Zaaphod/Smoothie_External_Drive_Interface/EPM240 EPM570 Core Board Schematic.png

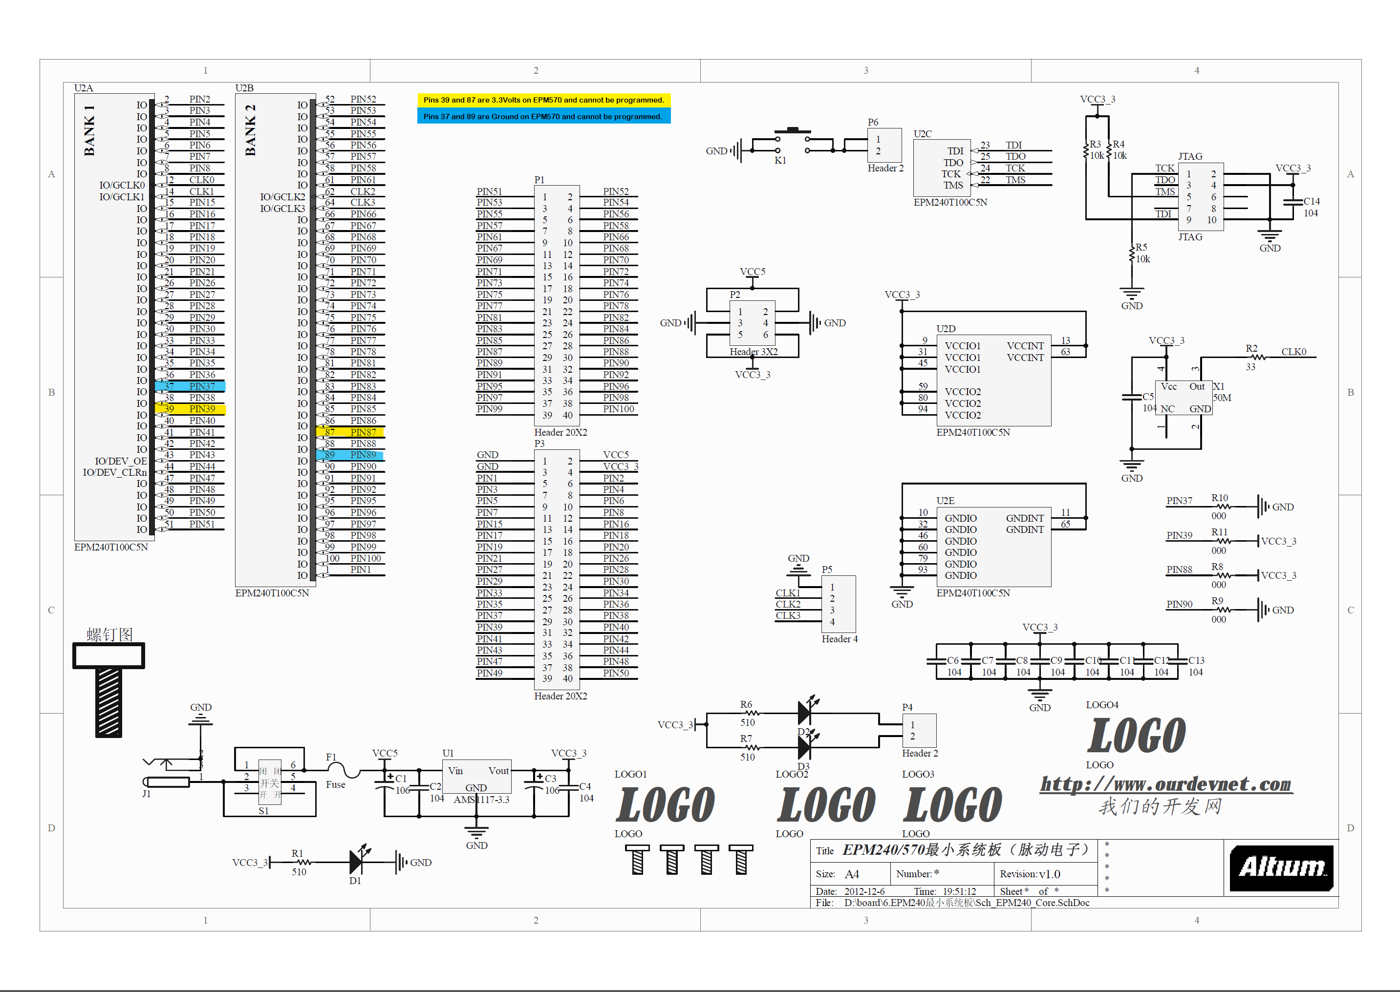
EPM240 EPM570 Core Board Schematic.png
