Zaaphod/Smoothie_External_Drive_Interface/(threads)

Thread 1 (2016-08-01):

Initial Benchtest

Zaaphod, 2016-08-01:
Here are the results of my initial bench test of this project.

I soldered the step and direction pins on a smoothieboard and hooked it up to my CPLD board with some jumpers.  Then I hooked up my logic analyzer to Xenable, Xstep, and Xdirection on smoothieboard, then hooked up Xstep, Xdelayed direction, Ystep and Ydelayed direction on the CPLD board.  I also hooked up my oscillator signal as a reference.
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

Here are some output waveforms:

First is the direction delay.
Grey waveform is the clock signal for the shift registers running at 5MHz
Red waveform is the step input from smoothie, showing the last step pulse before a direction change
Orange waveform is the original direction change that starts ~4µS after the rising edge of the last step  Yellow waveform is the X Step+ output from the CPLD, it is so close to the red input I can't measure it
Green waveform is the delayed direction change.    This confirms the direction signal has been delayed ~12µS and it is now past my 8µS step signal.  The signal shifts though 64 shift registers, the delay can be short by up to 200nS depending on what part of the cycle the clock was in when the delay signal transitioned.
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

Here is the actual measurement of the delay.  12.64µS
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

Here is the Y Delay output in purple, It happens well after the step signal is completed
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

To evaluate the performance of the CPLD, Here are closeups of the rising and falling edges of the step input from smoothie compared to the step output of the CPLD.  measurement of any difference is beyond the capability of my logic analyzer, even running at 100MHz.  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

Next I had a look at the X Axis differential step and direction outputs
Red is the Step input from Smoothieboard
Yellow is the Step + Output from the CPLD
Green is the Step - Output from the CPLD
Orange is the Direction input from Smoothieboard
Blue is the Direction + Output from the CPLD
Purple is the Direction - Output from the CPLD
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

Here is a closeup of some step pulses showing the differential output
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

Here is a closeup of a direction change showing the delay and differential output
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

so far the results are perfect. next step is to get it wired to a machine.

Thread 2 (2016-08-01):

EPM570 Schematic & Board

Zaaphod, 2016-08-01:
Here is the schematic of the CPLD
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

Here's the circuitboard I'm testing with.
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

Here are the CPLD pin assignments:
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

[Pin Wiring.txt](https://github.com/Zaaphod/Smoothie_External_Drive_Interface/files/394319/Pin.Wiring.txt)

Wiring for EPM570T100C5 Board#1
*Note Pins 37 and 89 are  Ground  on EPM570 and cannot be programmed
*Note Pins 39 and 87 are 3.3Volts on EPM570 and cannot be programmed

                                             13   12   11   10    9    8    7    6    5    4    3    2    1    <--DB Ribbon capble pins
         SX+  SX-  SY+  SY-  SZ+  SZ-  LED2  WR       XS-  XD-            XD+  XS+   WP   WD-  WD+ WS+  W-L
          99   97   95   91   89   87   85   83   81   77   75   73   71   69   67   61   57   55   53   51
         100   98   96   92  X90X X88X  86   84   82   78   76   74   72   70   68   66   58   56   54   52
         ZWP  ZSL  WSL  ZWR            LED3 ---  GND  GND  GND  GND  GND  GND  GND  GND  X+L  X-L  WS-  W+L
                             GND  3V3             25   24   23   22   21   20   19   18   17   16   15   14    <--DB Ribbon capble pins

                                             13   12   11   10    9    8    7    6    5    4    3    2    1    <--DB Ribbon capble pins
                    SEN  SXS  SYS  SZS IOSC       ZR   ZS-  ZD-  ZP  ZWP  ZD+  ZS+        YD-  YD+ YS+  Y-L
          5V  3V3    2    4    6    8   16   18   20   26   28   30   34   36   38   40   42   44   48   50
         GND  GND    1    3    5    7   15   17   19   21   27   29   33   35  X37X X39X  41   43   47   49
               SG   OSC  SXD  SYD  SZD XOSC XO/10 GND GND  GND  GND  GND  GND  GND  3V3  Z+L  Z-L  YS-  Y+L
                                                  25   24   23   22   21   20   19   18   17   16   15   14    <--DB Ribbon capble pins
Pin Definitions:
5V  -   5V Power
3V3 - 3.3V Power
GND - Ground Connection
LED1- On Board LED1 - Power Indicator01
LED2- On Board LED2 - Set to OSC/4000000 - blink led to show CPLD is working
LED3- On Board LED3 - Set to OSC/2000000 - blink led to show CPLD is working
XOSC- External Crystal Oscillator Monitor (50MHz)
XO/10 External Crystal Oscillator Divided by 10 (5MHz)
IOSC- Internal Oscillator (~3.3MHz-5.55MHz)
OSC - Oscillator Used by Shift Registers
SG  - Smoothie Ground
SX+ - Smoothieboard Input  X+ Limit
SX- - Smoothieboard Input  X- Limit
SY+ - Smoothieboard Input  Y+ Limit
SY- - Smoothieboard Input  Y- Limit
SZ+ - Smoothieboard Input  Z+ Limit
SZ- - Smoothieboard Input  Z- Limit
SEN - Smoothieboard Output Enable (any)
SXS - Smoothieboard Output X Step
SXD - Smoothieboard Output X Direction
SYS - Smoothieboard Output Y Step
SYD - Smoothieboard Output Y Direction
SZS - Smoothieboard Output Z Step
SZD - Smoothieboard Output Z Direction
ZWP - Smoothieboard Output Spindle Power - make high when spindle on selected head should be running
ZSL - Smoothieboard Output Z Select - make high to control Z axis and Z head with smoothie Z
WSL - Smoothieboard Output W Select - make high to control W axis and W head with smoothie Z
ZWR - Smoothieboard Input  Spindle Running
X-L - Machine X -Limit Switch - Connect to ground during limit
X+L - Machine X +Limit Switch - Connect to ground during limit
Y-L - Machine Y -Limit Switch - Connect to ground during limit
Y+L - Machine Y +Limit Switch - Connect to ground during limit
Z-L - Machine Z -Limit Switch - Connect to ground during limit
Z+L - Machine Z +Limit Switch - Connect to ground during limit
W-L - Machine W -Limit Switch - Connect to ground during limit
W+L - Machine W +Limit Switch - Connect to ground during limit
XS+ - Driver X Step+ - for rising  edge drivers or the + side of differential step signal
XS- - Driver X Step- - for falling edge drivers or the - side of differential step signal
YS+ - Driver Y Step+ - for rising  edge drivers or the + side of differential step signal
YS- - Driver Y Step- - for falling edge drivers or the - side of differential step signal
ZS+ - Driver Z Step+ - for rising  edge drivers or the + side of differential step signal
ZS- - Driver Z Step- - for falling edge drivers or the - side of differential step signal
WS+ - Driver W Step+ - for rising  edge drivers or the + side of differential step signal
WS- - Driver W Step- - for falling edge drivers or the - side of differential step signal
ZP  - Z Spindle Power Signal - Goes high when Z spindle is selected
WP  - W Spindle Power Signal - Goes high when W spindle is selected
ZWP - Z and W powerup Signal - Goes Low when either spindle is powered up, connects to low side of both spindle drives

b0redng33k, 2023-04-15:
@Zaaphod quick question, do you have the schematic of the EPM570 board your are using ?
TIA

Zaaphod, 2023-04-16:
@b0redng33k  You don't really need a schematic for the board because the information is silkscreened on the board itself.     It's really just a breakout board for the EPM240 and EPM570 CPLD chips.  The numbers by the header pins are the CPLD Pin numbers.  The crystal Oscillator is connected to pin 12 as indicated.
I don't have the schematic for the EPM570, but I do have it for the EPM240.

Please note that the EPM240 and EPM570 pinouts are slightly different, the EPM570 has fewer IO pins because it has a higher power requirement, so IO pins were used for additional power pins, this board ignores this, so those pins are still just connected to the headers. Technically they should be connected to power and ground to supply the chip correctly.  but I never bothered doing that.

Pins 39 and 87 are 3.3Volts on EPM570 and cannot be programmed.
Pins 37 and 89 are Ground on EPM570 and cannot be programmed.

Here's the Schematic for the board I highlighted the pin assignment differences:
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

b0redng33k, 2023-07-10:
> Here's the Schematic for the board I highlighted the pin assignment differences: 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

Great ! Thank you ! Now I understand better the behaviour I was having with D2,D3 and K1 in particular.

Thread 3 (2016-08-02):

Wiring Details

Zaaphod, 2016-08-02:
Here are the wiring details of the prototype CPLD to smoothie and to the DB25 cables.

First I had to modify the board to make room for the header connectors at the end of the DB25 Ribbon cable.  The connectors are too wide to fit between the pins, so one set of pins on the left side of each connector needed to be removed.  The two on bottom are only needed for diagnostic testing, and could have just been cut off,  however I decided to heat them up with my soldering iron and move them to the bottom side of the board to make further testing easier.
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

I soldered some wires over to the LEDs these two pins can't be used because of the ribbon cable ends anyway.
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

Here's are close ups of the ribbon cable headers and the headers plugged in
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

Next I wired it to smoothie with some ribbon cable jumpers
There are 3 groups of ribbon cables:
Step, Direction, & enable  group - Smoothie end
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

Step, Direction, & enable  group - CPLD end
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

Limit Switch and Power group
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

Spindle Control Group
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

Completed Wiring
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
