Zaaphod/Smoothie_External_Drive_Interface/(commit log)

2016-08-01 Board Photo
2016-08-02 Sample config switch section
    [config switch example.txt]
2023-04-16 Add Schematic for EPM240 / EPM570 Board
